Nobcha/R909-VFO_try2/LO_sourcrin.bmp

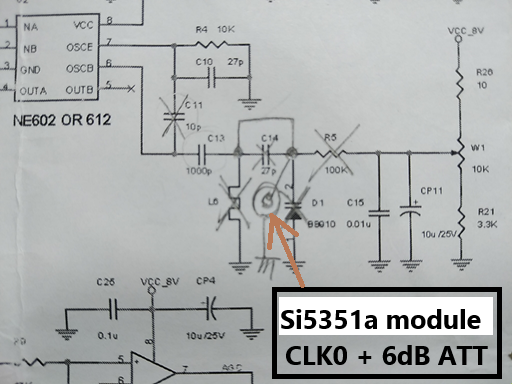
LO_sourcrin.bmp
