Nobcha/R909-VFO_try2/CON_NO4_SCM.jpg

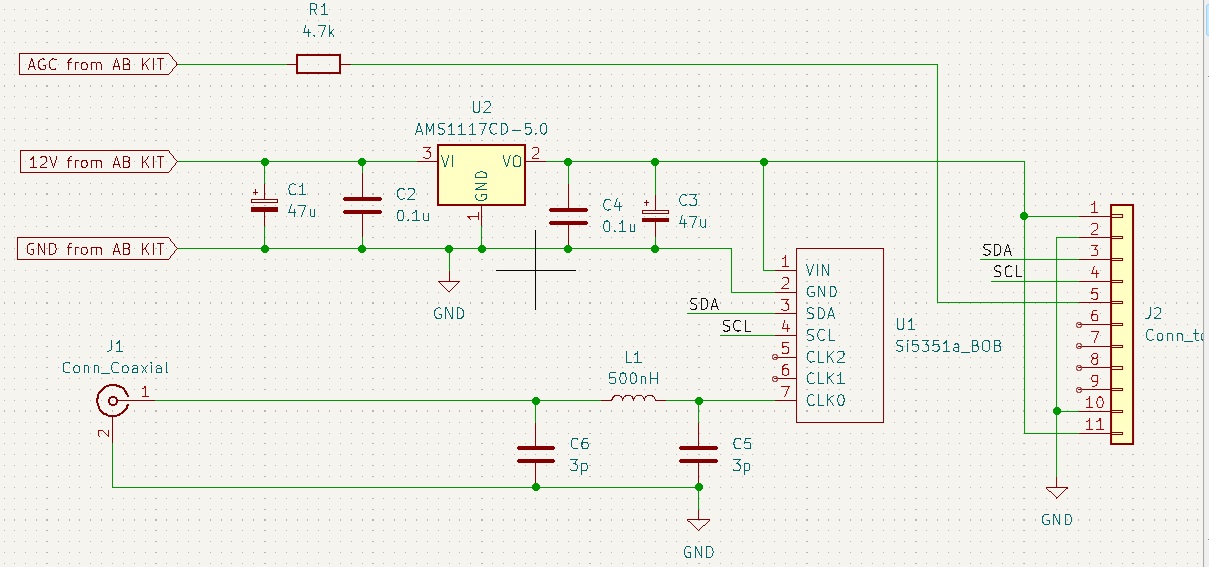
CON_NO4_SCM.jpg
