Nobcha/R909-VFO_try2/LM386追加実装＆ジャンパ2.jpg

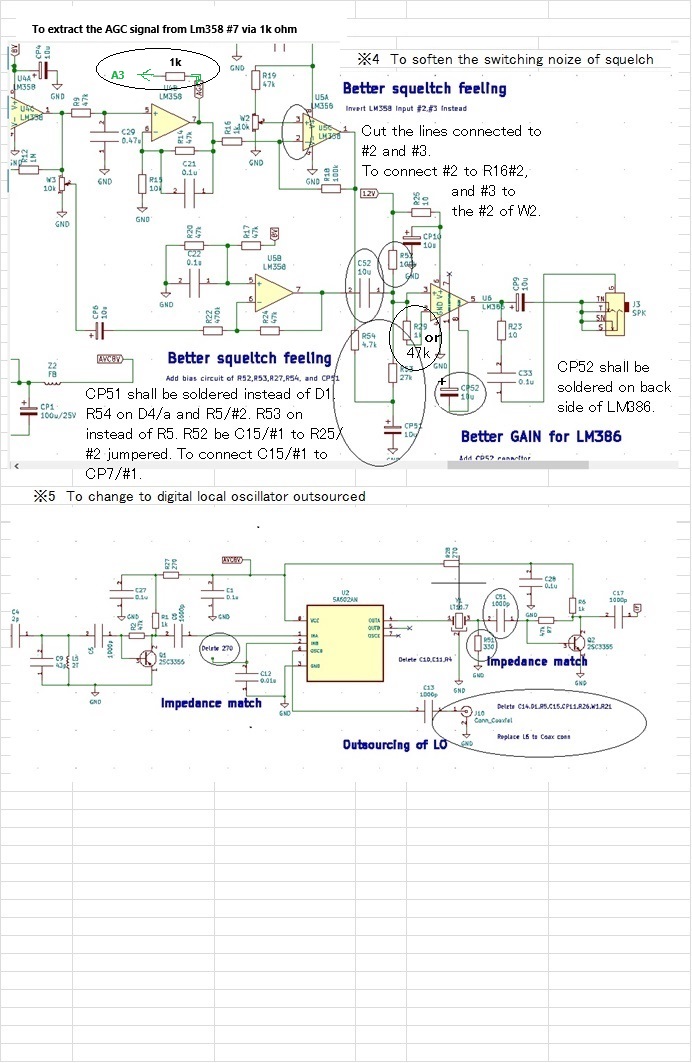
LM386追加実装＆ジャンパ2.jpg
