Nobcha/R909-VFO_try2/no4_BD.bmp

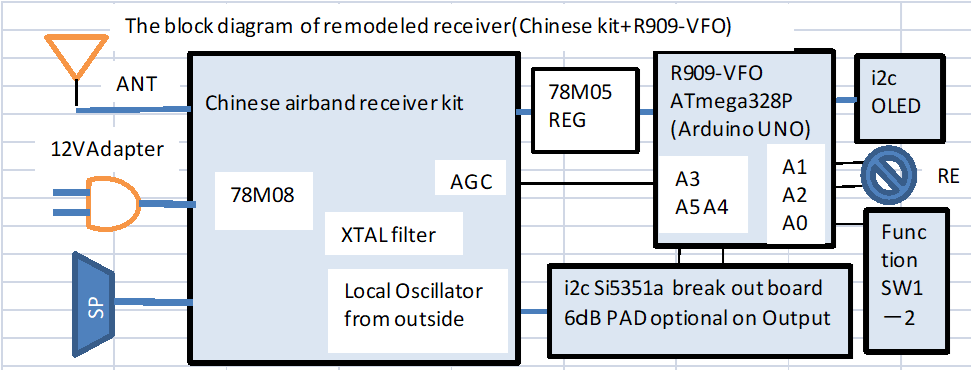
no4_BD.bmp
