Nobcha/R909-VFO_try2/panel_scm.jpg

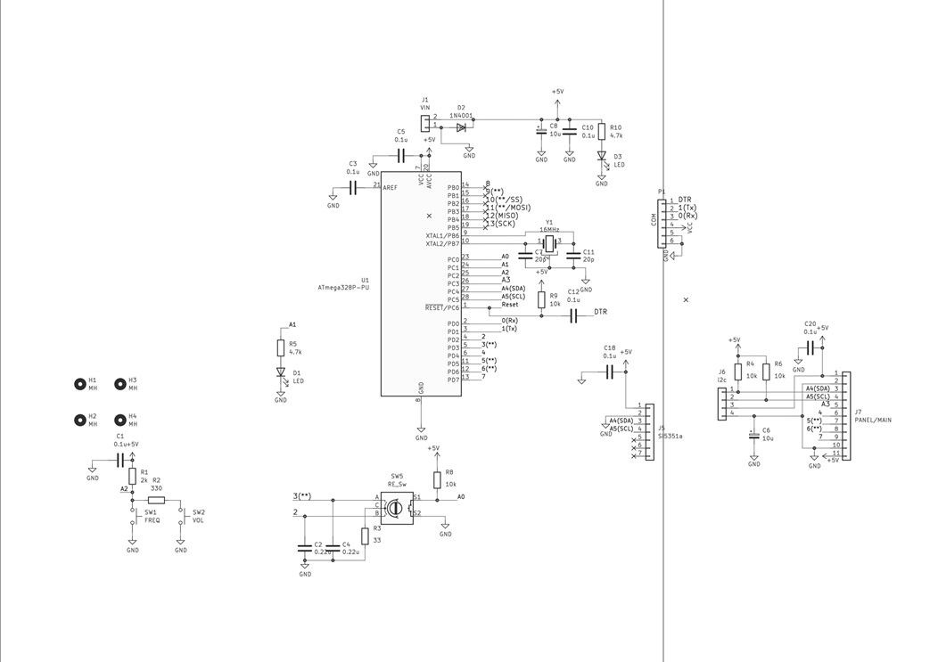
panel_scm.jpg
