Nobcha/R909-VFO_try2/CON_NO4_BOM1.jpg

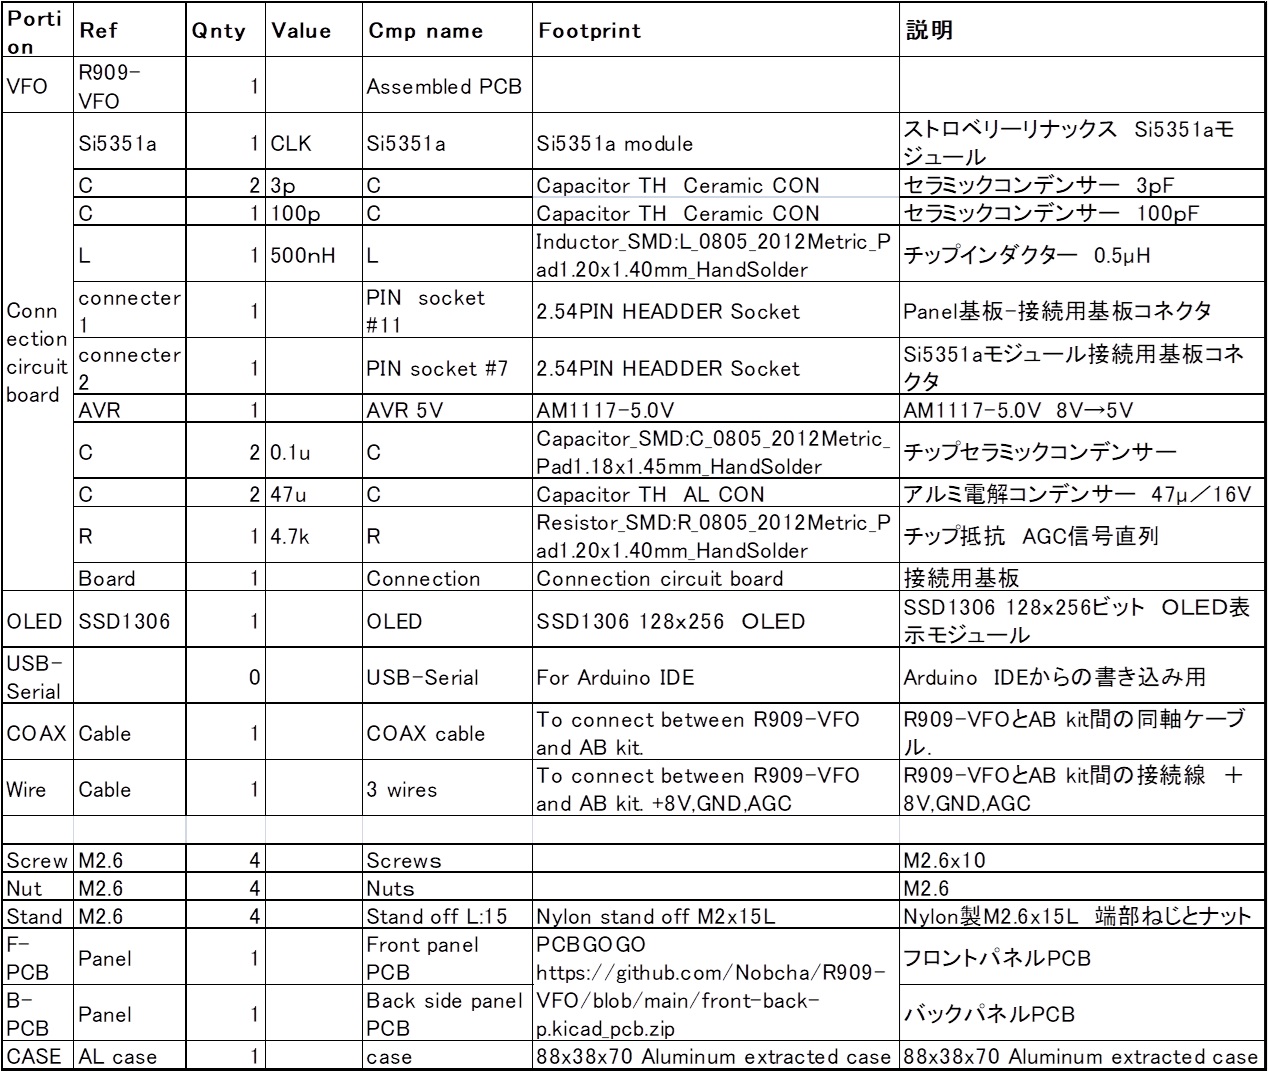
CON_NO4_BOM1.jpg
