Nobcha/R909-VFO_try2/R909-VFO_NO4_BOM1.jpg

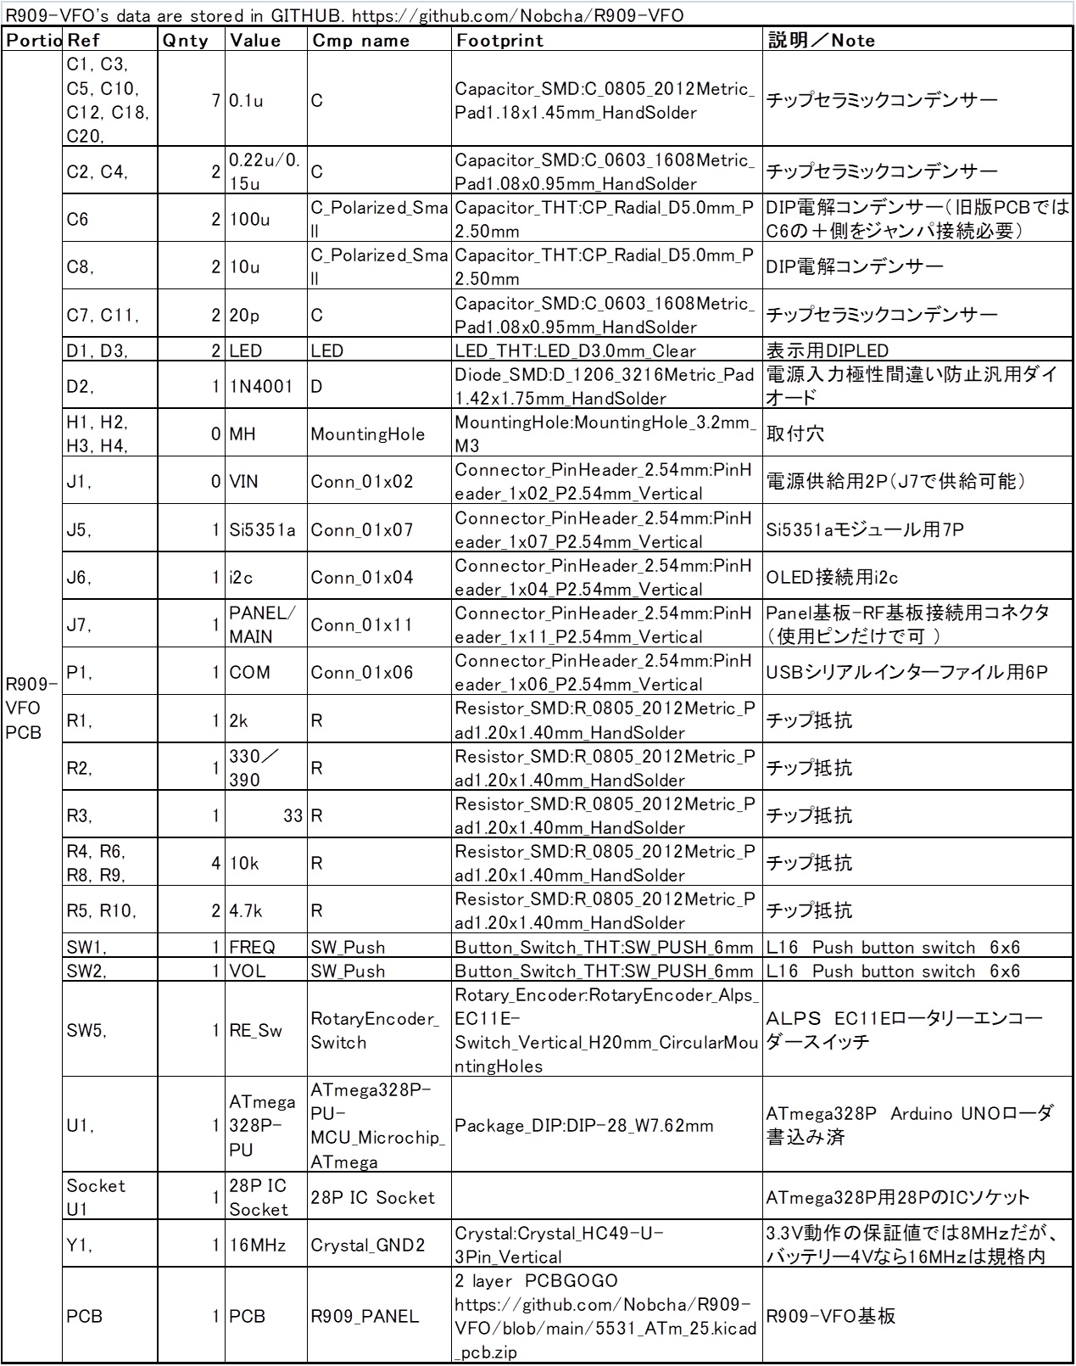
R909-VFO_NO4_BOM1.jpg
