Nobcha/R909-VFO_try2/(commit log)

2024-10-03 R909-VFO for the Chinese kit modified
    To remodel the Chinese kit for the digital local oscillator and improving specifications.
    [R909-VFO_ABKITV41.ino]
2024-10-03 To avoid the pop noise on squelch switching
    This is an idea for choking LM386 circuit without pop noise.
2024-10-03 The BOM for the connection board.
    You shall need some parts and wires to connect R909-VFO with the Chinese air band receiver kit.
2024-10-03 LO sourced outside
    To remodel the circuit for LO sourcing outside.
2024-10-03 The BOM for R909-VFO
    R909-VFO
2024-10-03 The connection board schematics
    This connects the R909-VFO with Si5351a module.
2024-10-04 R909-VFO schematic
2024-10-08 Add files via upload
    Assembling and operation manual.
